tom130398/Temperature-Sensor-Arduino-/README.pdf

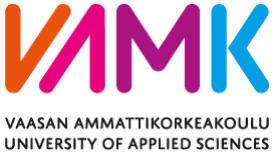
[picture p1: figure]

Luong Diem Quynh (e1601128)

Tuan Hoang Nguyen (e1601111)

Van Quy Thanh (e1601139)

# ELECTRONIC THERMOSTAT

Digital System Design

School of Technology

### CONTENTS

According to our research, the cheapest solution to transfer can be

found are RS232VSCurrent loop and RS232, with the price is

8.2 You need to make your PCB (embedded system) compliant with EMC.

8.4 What is the inductance (nH/cm) for PCB-trace which w = 10 cm, wt =

8.5 In circuit theory capacitor is pure (ideal) capacitor. Which components

### 1 ABSTRACT

In this course, we learn about the mechanism of electronic components for both

analog and digital and how they can be connected and communicated to microcon-

trollers. We also have a chance to develop and build a small microcontroller-based

system, which is a electronic thermostat in this case.

### 2 INTRODUCTION

We perform this laboratory report in order to record our work process during the

whole course and to understand more about the concept of electronic components

and how to use them to build a system. This report also resumes our total 112h work

load during the course. The contents include our understanding of electronic design

and mechanism of electronics components. Digital systems simulation, operations

of electrical components embedded to a microcontroller, Printed Circuit Board de-

sign methods and manufacturing. EMC-interferences and testing, robust design.

### 3 PRE-DESIGN

### 3.1 Device description

As requirements, the product has to manage the property monitoring and control.

The product will be used in small summer cottage or middle size summer cottage.

The designed device is consumer product and it can be used for other small build-

ings monitoring as well. The marketing area for the product is world-wide. The

product contains a temperature measurement system which can be used to measure

temperature at distance of 100 meters (wireless communication cannot be used be-

cause of steel walls between measurement point and the main device).

### 3.2 Functional Requirements

### 3.2.1 Temperature Measurement

Several requirements have to be reached when implementing temperature measure-

ment part inside products

1. The ambient of temperature is by 0.5 ° C accuracy
2. Measurement range should be at least -30 + 30 ° C
3. Measured temperature is constantly informed in device screen.

### 3.2.2 Communication

When implementing the communication part of device, we should also consider

these conditions

1. The transmitter is capable of transferring temperature information at least

100 meters.

2. Environment contains sensors are equipped with transmitter.
3. Main unit contains intelligence and sensor inputs.
4. Transmitter does not use expensive components.
5. Communication can be used in environment which contains electromag-

netic interference (communication should not get interfered because of dy-

namic 10 V/m electric field).

### 3.2.3 Heat Control

Heat control is also a necessary part of system and should meet some requirements

1. System is capable to control up to five radiators and each radiator contains

three different size heat resistors.

2. Each resistor can be controlled separately and each radiator contains its own

control relays.

3. User can adjust desired temperature by using keyboard (0.5° C accuracy).
4. Temperature control must take place in one second response time.

### 3.2.4 Antitheft Alarm System

The system is capable to maximum eight events at the same time (doors, windows

or other hatches). In addition it is possible to connect five motion detectors and

five smoke alarms to the system. The motion detectors and the smoke detec-

tors will provide an alarm (binary information). The system should inform alarms

by siren and flashing lights. The basic system does not need to be a remote con-

trolled, but remote controller feature should be taken into account because of the

device future generations.

It is possible to turn off the alarm system from its own keyboard. The password

needed when user wants to turn off the alarm system. The alarm system should

contain a delay function which means that the alarm is given after 15/30 seconds

from sensor event. Delayed alarm should be informed with buzzer.

### 3.2.5 Temperature Registration

The functionality of temperature registration also needed to be ensured

1. Device is capable to collect measured data
2. Memory data should be big enough for one week data quantity
3. User can browse measured results in device screen or results can be sent via

serial communication to personal computer

4. Measured values should be kept in the memory during power failure at least

five hours

5. User can change the sampling rate of measurement values.

### 3.2.6 Interfaces requirements

1. Device should contain a keyboard which can be used to set value for tem-

perature control. The keyboard can be used to feed password. The device

should contain a display to show temperature values

2. The device can be controlled from personal computer which uses RS-232

communication between device and personal computer.

3. The device collects measured data and counts every single day minimum

temperature, maximum temperature and average temperature

4. The device can be programmed via serial communication and the data can

downloaded to personal computer via serial communication. Serial commu-

nication settings are fixed so settings not need to be changed

### 3.2.7 Other requirements

- Accuracy of measurement 0.5 °C
- Range of measurement. -30 °C ... +30 °C
- Response time for control 1 s
- Responding to the alarm 0.5 s
- Easy to use and no special skills needed from user.
- Must be protected against power failure. The device is able to be in idle state for at least five hours.
- Device parameters can be changed from device keyboard and from personal computer
- The device operating temperature range should be -40 °C ... 50 °C and environment relative humidity < 90%.

### 3.2.8 Design Restrictions

- The device should be small as possible
- Only GCC C-compiler allowed when developing the software.
- The power consumption should be as small as possible.

### 3.3 Block diagram of the device

Base on requirement description, we came up with the system component structure

under block diagram. The block diagram can be seen under figure 1 below.

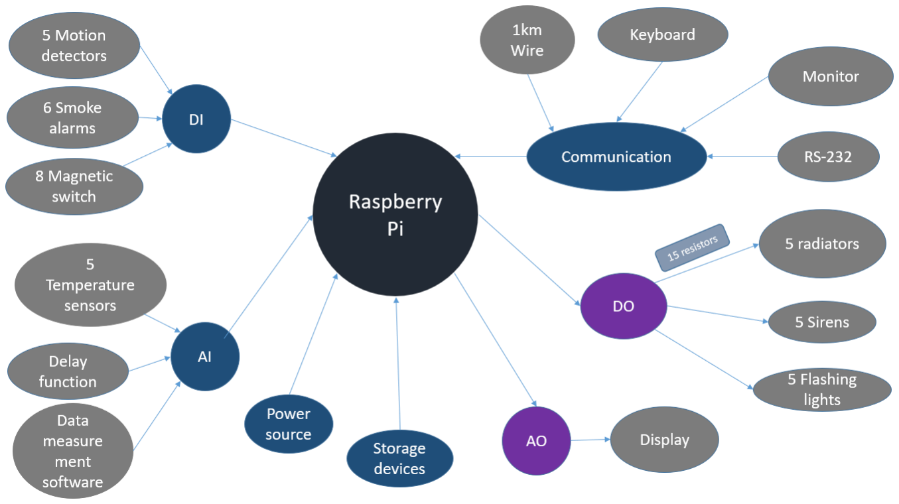
[picture p2: figure]

Figure 1. Block diagram that describe structure of device

Inside this block diagram, we use Raspberry Pi as a middle device that receives

every input and sends out data as an output in the system. Any devices or compo-

nents which is connected to Raspberry Pi as an input will have blue color, outputs

are purple and outer devices will have gray color. As we defined color of different

components in this way, it is easier for us to look at and build system later on.

For example, Digital Input (DI) is connected as an input device to Raspberry Pi

(because it has blue color) and there are three other components also connected as

inputs of DI which are: 5 motion detectors, 6 smoke alarms and 8 magnetic

switches. For another example, Analog Output (AO) is connected as an output to

Raspberry Pi (because it is purple) and it has other devices to connected to as its

output which is Display (Display analog statistics on user device). Or simply, we

just need to take a look on the arrow direction.

### 3.4 Device features

### 3.4.1 Manufacturing price

Base on the block diagram that has been defined on previous part, we will consider

about device features and price for a completed device.

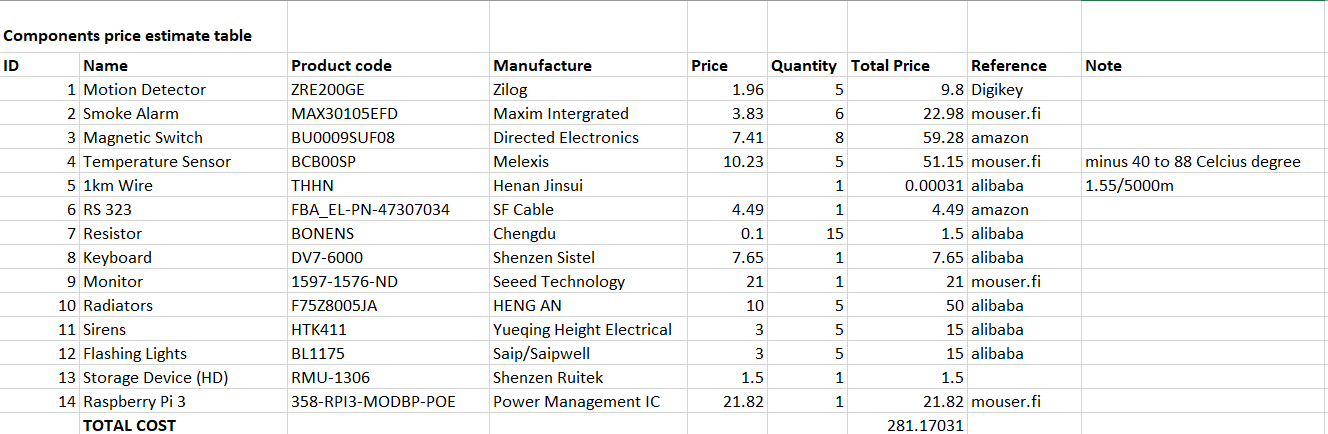
[picture p3: figure]

Figure 2. Component Price Estimated Table.

We have made several researches on some popular websites which sells electronic

components and picked up the most suitable price and components for our digital

system. The component features, quantities and prices after being filtered can be

displayed on figure 2 above.

According to our research, the whole system cost will be approximately in 281 Dol-

lar (which is around 240 Euro). The estimated duration to manufacture and finish

this system will range from 50 to 100 hours with 2-3 people work together. Base on

Finnish work labor statistics, it costs around 10-15 Euro to hire a person to work in

1 hour. To sum up, base on our research about devices features and prices as well

as work labor statistics, we come up with the total price below

Maximum Manufacturing Cost = Components + Manufacturing Costs

Maximum Manufacturing Cost = 281 + 100 × 3 = 581 Euro

So, the maximum manufacturing cost for this digital system can be reach to 581

Euro as the highest peak.

With each system, we estimated profit for company is about 100-150 Euro. So, the

total cost that customer may have pay for this can be calculated as

Total Cost = Maximum Manufacturing Cost + Company Profit

Total Cost = 581 + 150 = 731 Euro

Base on the result, the total amount that customers need to pay for the whole system

is estimated as 731 Euro for each.

### 3.4.2 Accuracy of measurement

The temperature sensor which was chosen on previous part ranges from -40 to 80

degree of Celsius with accuracy value is 0.5 °C. It has a larger range than require-

ments (which ranges from -30 °C to 30 °C)

So, with this temperature sensor, the smallest measurable change in temperature

with this temperature sensor is 0.5 °C. And the minimum operating temperature is

-40 °C and the highest one is 80 °C.

### 3.5 Different communication methods

The comparison between different communication methods can be seen under the

table below, based on several factors : Distance between transmitter and receiver,

external factor communication, price, advantages and disadvantages.

Almost price statistics were taken from amazon so that we can have a fair compar-

ison when comparing the price among devices.

| Dis-tance | External factor communi-cation | Price | Advantages | Disadvantages
Current loop | 600m | For serial communication, a current interface that uses current instead of voltage for signaling. Current loops | 100-150 USD | Long distance and noise immune trans-mission of data | No mechanical or electri-cal standard

can be used over moder-

ately long distances

RS232 | 50ft | Serial | communication,

used to connecting com-

puter and its peripheral de-

vices to allow serial data

exchange between them.

14.95

USD

RS232 | interface | is
supported | in many

compatible legacy de-

vices due to its sim-

plicity

It supports long dis-

tances and with error

correction capabilities.

Low cost and immune

to noise

It is not suitable for chip

to chip or chip to sensor

device communications.

Supports lower speed for

long distances.

RS232 interface requires

separate transceiver chips

which will add cost to the

system.

It is unbalanced transmis-

sion.

RS485 | 4000ft | Star and ring topologies are not recommended because of signal reflections or ex-cessively low or high ter-mination impedance. If a star configuration is una-voidable, special RS-485 repeaters are available which bidirectionally listen for data on each span and then retransmit the data onto all other spans. | 15.95 USD | Immune to noise. | It supports single master and multiple slaves.
RS232V SCur-rent loop | 500ft | can accept loop currents of either 20mA or 60mA and convert them to RS-232 data. | 82 EUR | Provide better protec-tion against the electri-cal interference gener-ated by the air

| suited to protecting data communication being car-ried out in environments where the terminating equipment has high voltage sources. | | conditioning unit, it can accept loop cur-rents of either 20mA or 60mA and convert them to RS-232 data.
CAN BUS | communicate with each other in applications with-out a host computer (https://en.wikipedia.org/wiki/Host_computer) | 14.55 USD | Supports distributed real-time control with a very high level of se-curity. Provide feature im-proves the network re-liability and transmis-sion efficiency | It is likely to have unde-sirable interactions be-tween nodes. CAN driver must produce at least 1.5V across typi-cal 60 Ohm. Network should be wired in topology which limits stubs as much as possible.

MOD

BUS

communication among

many devices connected to

the same network, for ex-

ample, | a | system | that

measures temperature and

humidity and communi-

cates the results to a com-

puter.

49.99

USD

offers flexibility of

type of data that can be

communicated to other

devices.

Data transfer designed

for industrial applica-

tions

Moves raw bits or

words without placing

restrictions on vendors

No standard method for a

node to find the descrip-

tion of a data object, i.e.

finding a register value

represents a temperature
between 30◦

and 175◦

No security against unau-

thorized commands or in-

terception of data

Transmissions must be

contiguous which limits

the types of remote com-

munications devices to

those that can buffer data to avoid gaps in the trans-

mission.

Table 1. Comparison between different communication method

According to our research, the cheapest solution to transfer can be found are

RS232VSCurrent loop and RS232, with the price is approximately 15 Euro.

### 4 ANALOG SIGNAL PROCESSING

### 4.1 Design

In this part, we will design temperature sensor circuit, buffer circuit and differential

amplifier circuit. Sensor LM35 output voltage will change -0.3V to +0.3V when

environment temperature changes -30 C to +30 C. The differential amplifier will be

used to gain input voltage (-0.3V to 0.3V) to wanted level (0V-3V) as we can see

under figure 3 below.

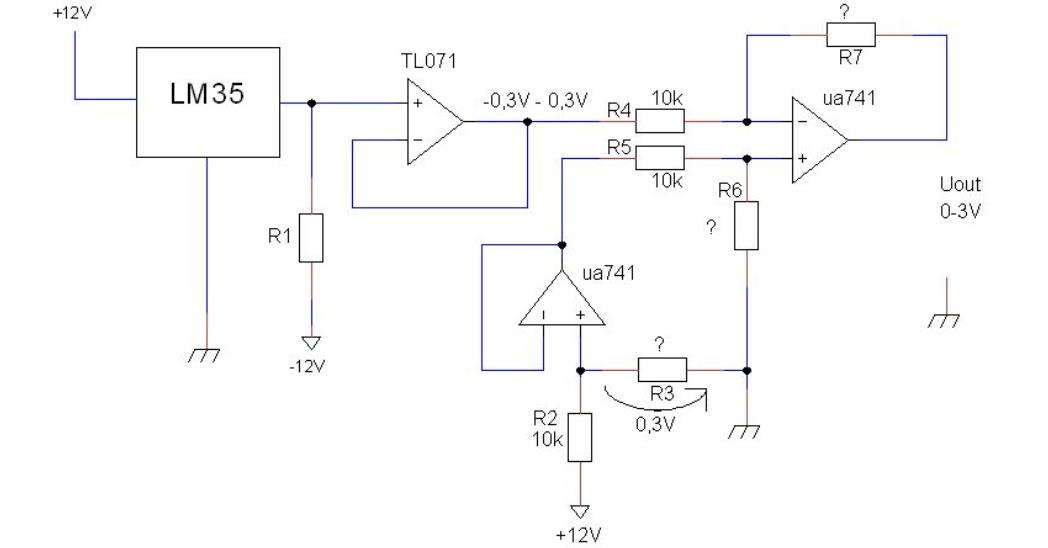
[picture p4: figure]

Figure 3. Differential amplifier circuit

The calculation process for two unknown components can be described below.

- R1

We will first start with R1

R1 = −

V2
50uA =

12
50uA = 240k
- R3

According to the voltage divider equation, we have U3
R3

=

U2
R2
We also have U3 = 0.3V,U2 = 12 − 0.3 = 11.7V U3
U2

=

R3
R2

=

1
39

R3 =

1
39 × R2 =

1
39 × 10000 = 256.41
- R6, R7

According to differential amplifier equation, we have : R6 = R7

Vout =

R7
R5

(Va − Vb)

We also have : Vout = 3V

R7 = −

Vout R5
Va − Vb = −

3 × 10k
(−0.3 − 0.3)

= 50k

So, in this case: R6 = R7 = 50k

### 4.2 Simulation

After calculating unknown component values, we have the LTSpice simulation as

can be seen under figure below. In this simulation, we measured and plotted the

diagram of I1 and V1

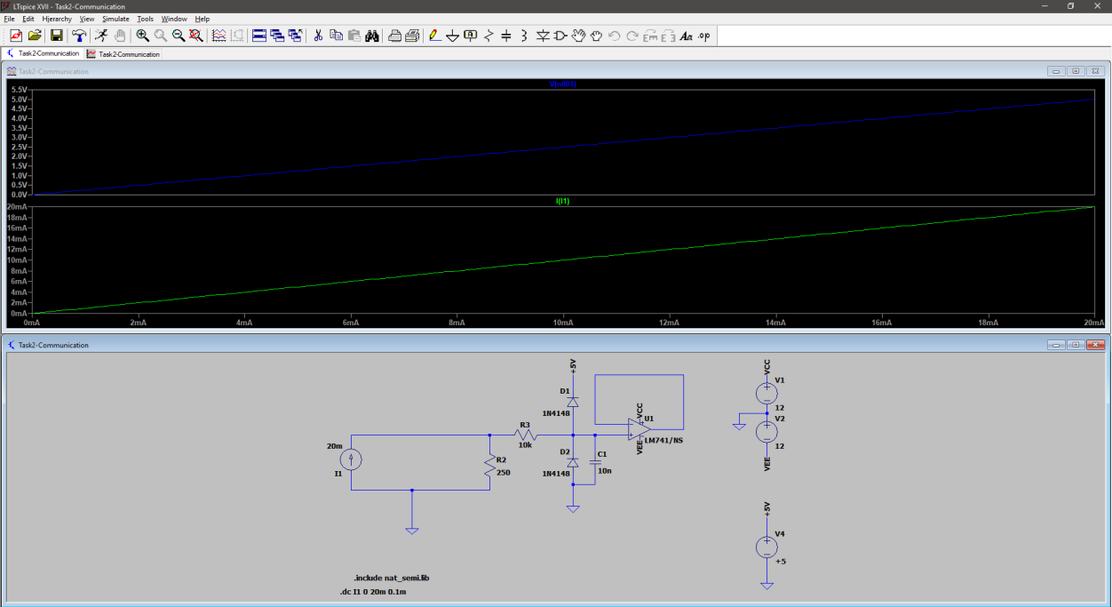
[picture p5: figure]

Figure 3. Simulation using LTSpice.

We can see that the two diagrams are corresponding to each other.

- V1 ranges from 0V to 5.5V
- I1 ranges from 0A to 20mA

With V1 = 0V, we have I1 = 0A as a corresponding value

With V1 = 5.5V, we have I1 = 20mA as a corresponding value.

### 4.3 Circuit testing and verification in breadboard

The breadboard general schematic can be found under figure 4 below.

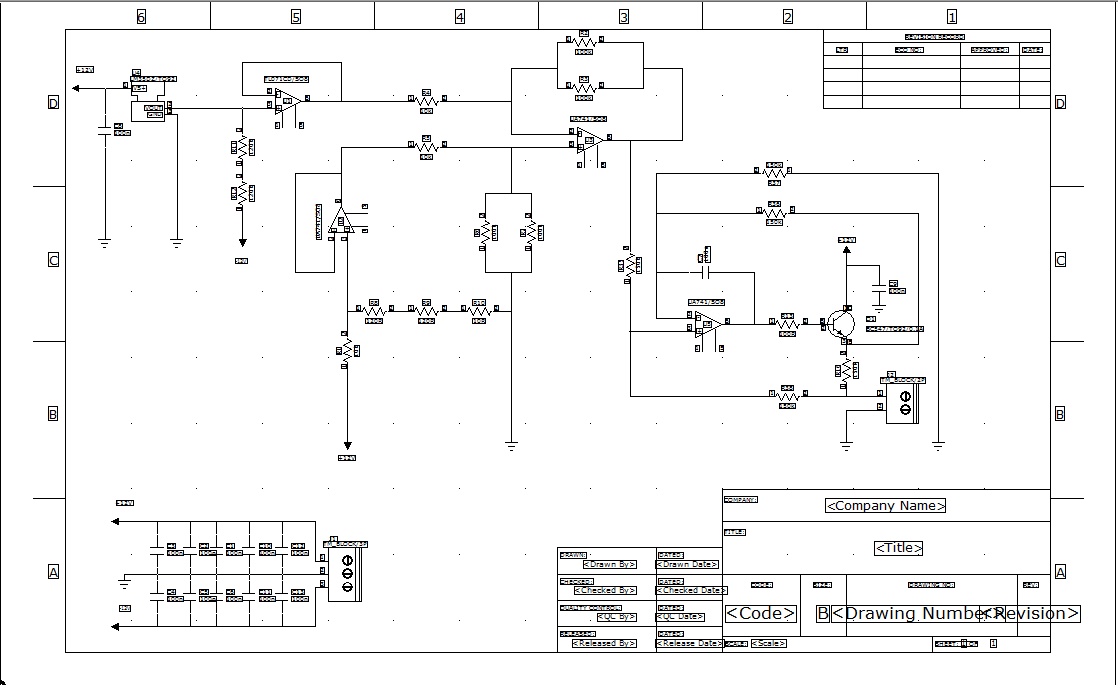
[picture p6: figure]

Figure 4. Bread board schematic

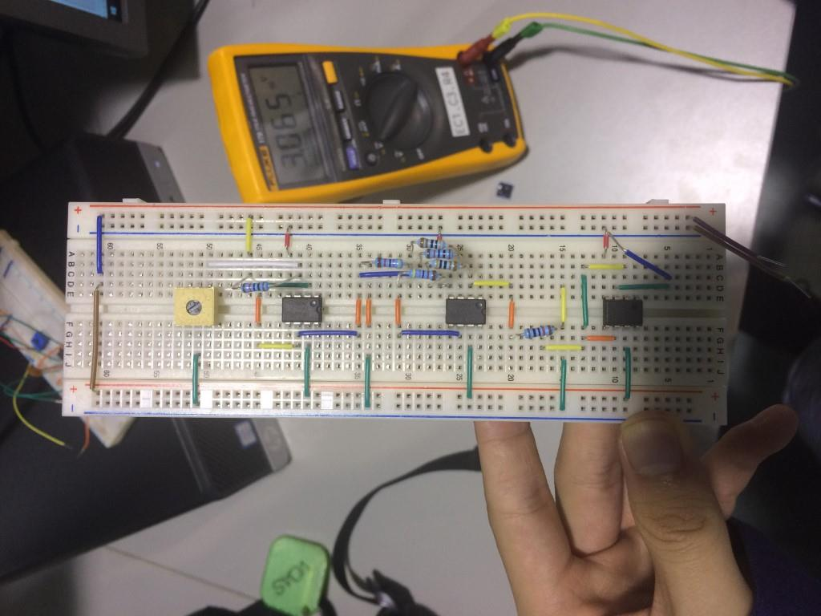
[picture p7: figure]

Figure 5. Bread board circuit

After finishing the circuit on breadboard, we did some measurement with input

voltage (Vin) and output voltage (Vout). Hence, we came up with the statistics can

be seen under figure 5 below.

From statistics gain from table, we can plot the diagram with two separated lines:

the blue line represents Vin while orange line represents Vout. The Vout line graph

increases while in the same time, Vin line graph is quiet decreasing by time.

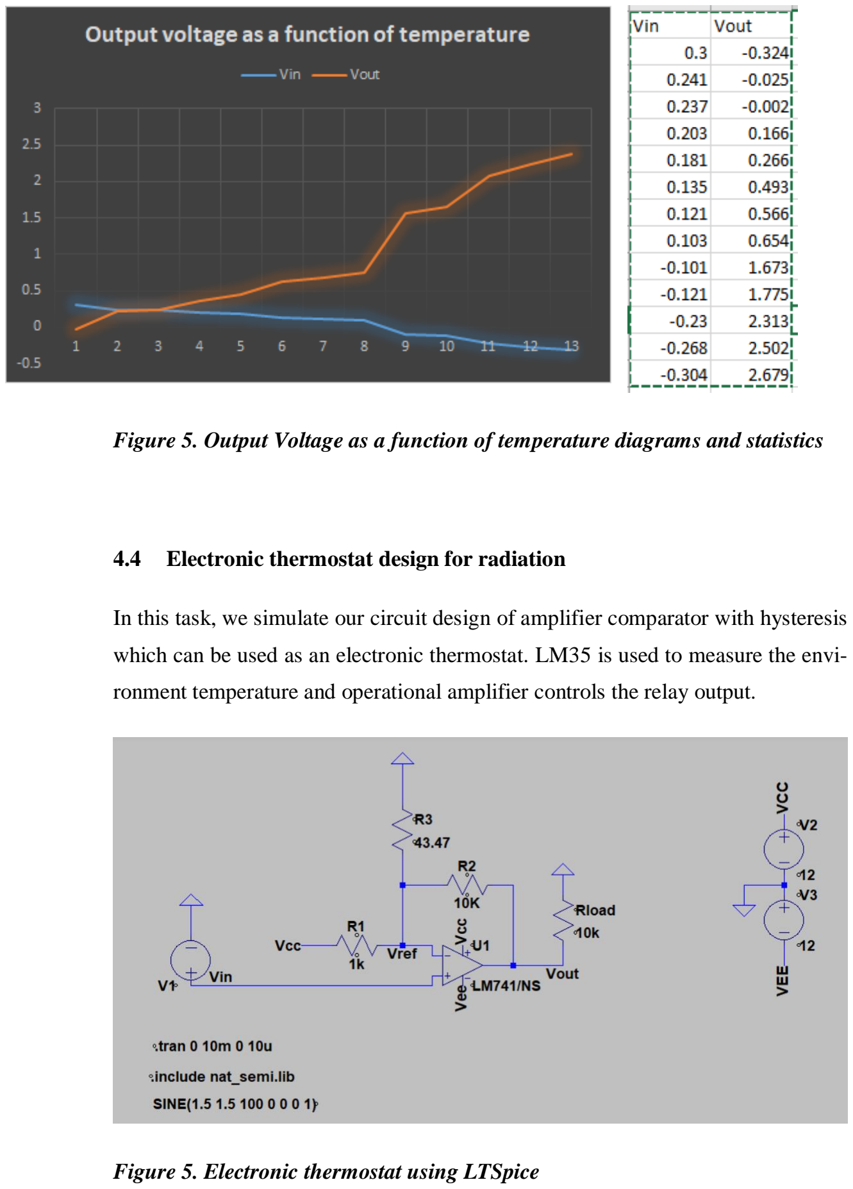
[picture p8: page 19]

Figure 5. Output Voltage as a function of temperature diagrams and statistics

### 4.4 Electronic thermostat design for radiation

In this task, we simulate our circuit design of amplifier comparator with hysteresis

which can be used as an electronic thermostat. LM35 is used to measure the envi-

ronment temperature and operational amplifier controls the relay output.

Figure 5. Electronic thermostat using LTSpice

The circuit plotting diagram can be seen under figure 6 below with three lines rep-

resent for three variables : V out, V in and V ref

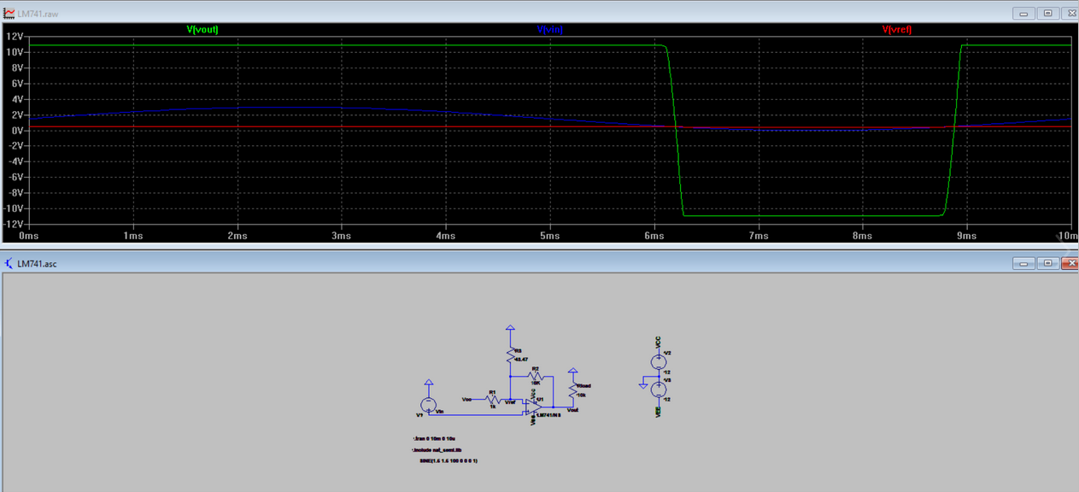
[picture p9: figure]

Figure 5. Electronic thermostat plotting diagram using LTSpice

### 5 COMMUNICATION

### 5.1 Transmitter

### 5.1.1 Design and calculation

In the previous part, we have designed and simulated temperature sensor circuit,

buffer circuit and a differential amplifier circuit. The solution is also tested and

verified in bread board.

In this part, we continue to build the remain part of system, transmitter. To simply

understand, the output of previous system is designed as an input for this system.

We have done the first part, now we continue moving on to next part. The circuit

can be seen under figure 7 below

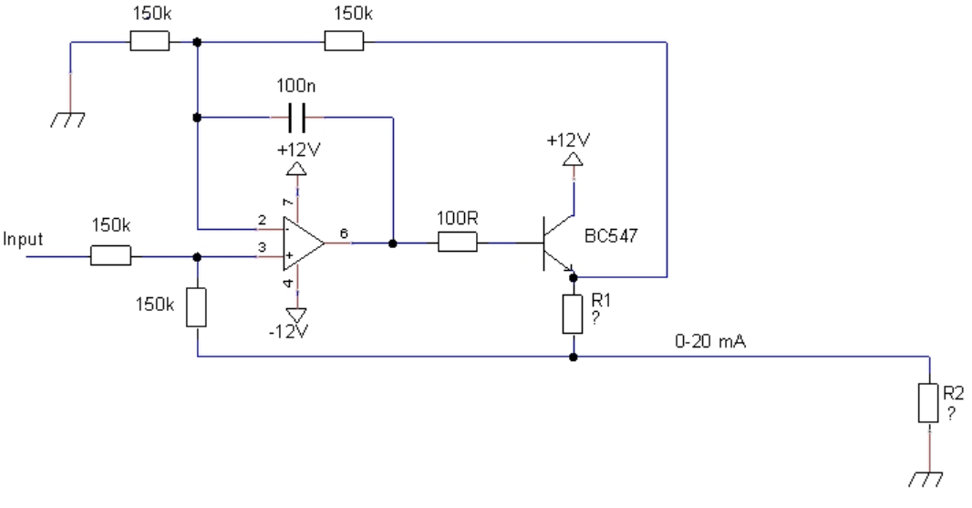
[picture p10: figure]

Figure 7. Communication Transmitter

- The BC548 is a general-purpose NPN bipolar junction transition com-

monly used in European and American electronic equipment. It is notably

often the first type of bipolar transistor hobbyists encounter and is often

featured in designs in hobby electronics magazines where a general-pur-

pose transistor is required. The BC548 is low in cost and widely available.

- An LM741 operational amplifier is a DC-coupled high gain electronic

voltage amplifier. It has only one op-amp inside. An operational amplifier

IC is used as a comparator which compares the two signal, the inverting

and non-inverting signal. The main function of this IC is to do mathemati-

cal operation in various circuits. Op-amps have large gain and usually used

as Voltage Amplifier. The LM741 can operate with a single or dual power

supply voltage.

- In order to have 0-20 mA current through R1 when input voltage varies 0-

3 V DC and current 20 mA flows in circuit the resistor R2 must have 5V

over it, the value of R1 and R2 should be

R1 =

Vin
I

=

3V
20mA = 150Ω

R2 =

V2
I

=

5V
20mA = 250 Ω

### 5.1.2 Simulation

Base on the obtained result on previous part, we come up with this circuit simulation

on LTSpice. As can be seen on plotting area under figure 8 below, two values have

been simulated. We can easily see that :

- With I = 0A, the corresponding value of V = 0V
- With I = 20mA, the corresponding value V = 5V

These simulation are exactly the same with requirements on design part.

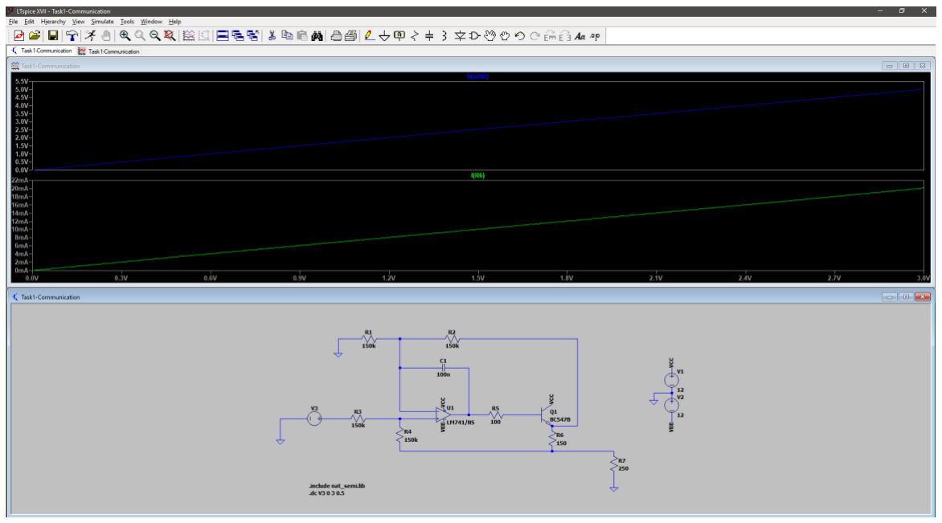
[picture p11: figure]

Figure 8. Communication Transmitter Simulation

### 5.1.3 Breadboard circuit testing and verification

The bread board implemented on circuit can be seen on figure 9 below. At this

point, we are testing and verifying this circuit using multimeters.

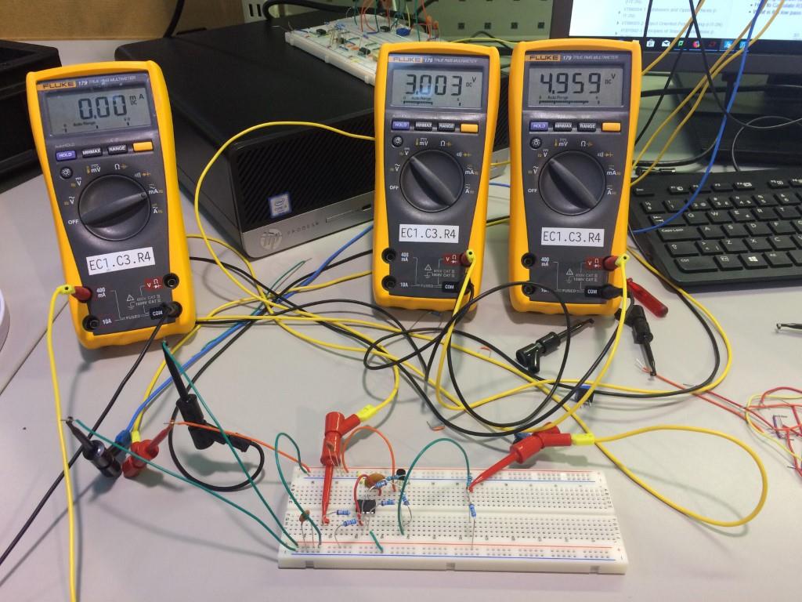
[picture p12: figure]

Figure 9. Communication Transmitter Circuit

After finishing the circuit on breadboard, we did some measurement with input

voltage (Vin) and output voltage (Vout). Hence, we came up with the statistics can

be seen under figure 10 below.

From statistics gain from table, we can plot the diagram with two separated lines:

the blue line represents Vin while orange line represents Vout. Both line graphs

have the same trend which are decreasing.

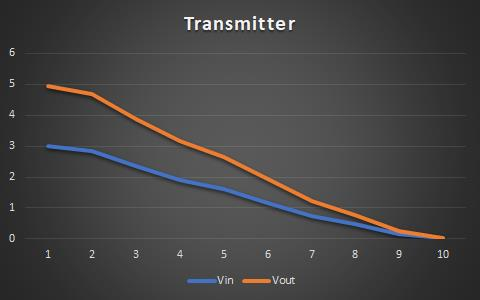
[picture p13: figure]
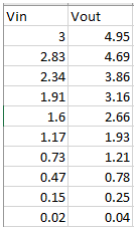
[picture p14: figure]

Figure 10. Communication Transmitter Diagram and Statistics

### 5.2 Receiver

### 5.2.1 Design and Calculation

The design of receiver can bee seen under figure 11 below.

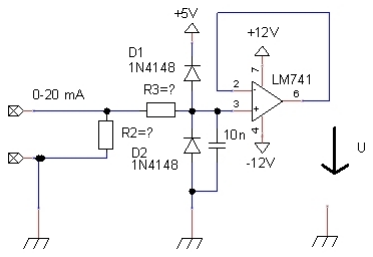
[picture p15: figure]

Figure 11. Communication Receiver Circuit

In order to have input signal contains 8 kV ESD discharge voltage and that current

during this ESD event through D1 or D2 is 0.8A, we should have value of R2 and

R3 as below

R2 =

Vin
I

=

5V
20mA = 250Ω

R3 =

V3
I3

=

8000V
0.8A

= 10000 Ω

The low pass filter cut-off frequency is

f =

1
2πRC =

1
2π × 10000 × 10 × 10⁻⁹

= 1600 Hz

### 5.2.2 Communication Receiver Simulation

Base on the obtained result on previous part, we come up with this circuit simulation

on LTSpice. As can be seen on plotting area under figure 8 below, two values have

been simulated. We can easily see that :

- With I = 0A, the corresponding value of V = 0V
- With I = 20mA, the corresponding value V = 5V

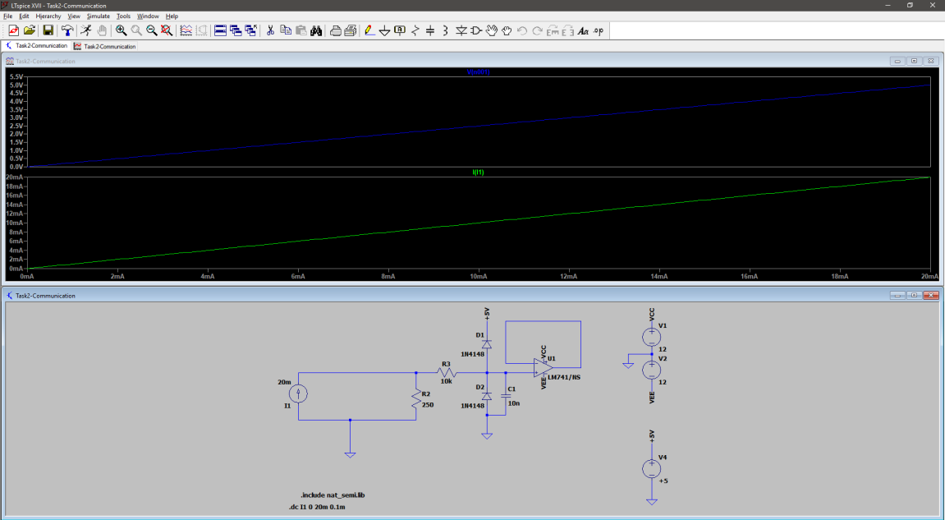
[picture p16: figure]

Figure 12. Communication Receiver Simulation

### 5.3 Test system in bread board

The receiver circuit bread board after being implemented can be seen as in the Fig-

ure 13 below. In this testing, we replace LM35 by DC-power supply and adjust -

0.3V to +0.3V using 0.1V steps. Measure current from current loop and measure

receiver output voltage.

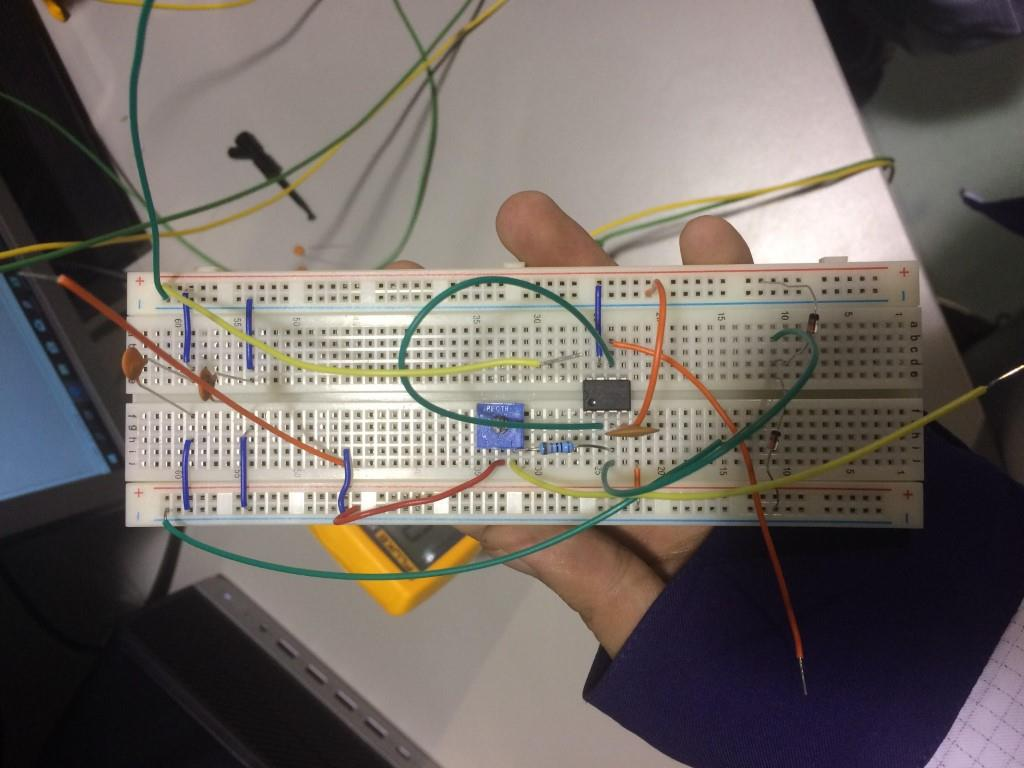
[picture p17: figure]

Figure 12. Communication Receiver Bread Board Circuit

After that, we did some measurement with input current (I in) and output voltage

(V out) of the receiver. Hence, we came up with the statistics can be seen under

figure 11 below. From statistics gain from table, we can plot the diagram with two

separated lines: the blue line represents Iin while orange line represents V out.

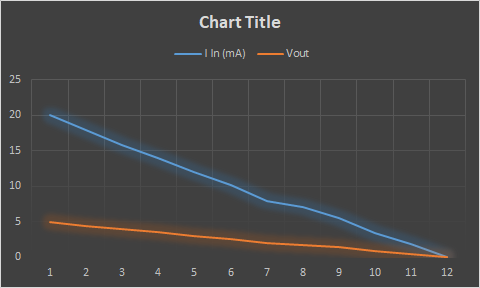
[picture p18: figure]

Figure 13. Communication Receiver Diagram and Statistics

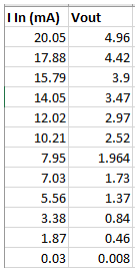
[picture p19: figure]

### 6 ANALOG TO DIGITAL CONVESION

### 6.1 Design

The different between MCP3002 and ADC0832 chips is described as

- MCP3002 is a 10-bit Analog-to-Digital Converter (ADC) combines high

performance and low power consumption in a small package, making it

ideal for embedded control applications. MCP3002 features 200k sam-

ples/second, 2 input channels, low power consumption (5nA typical

standby, 520µA typical active), and is available in 8-pin PDIP, SOIC and

TSSOP packages.

- ADC0832 is an 8-bit successive approximation A/D converter with a serial

I/O and configurable input multiplexers with up to 8 channels. The 2-, 4- or

8-channel multiplexers are software configured for single-ended or differ-

ential inputs as well as channel assignment.

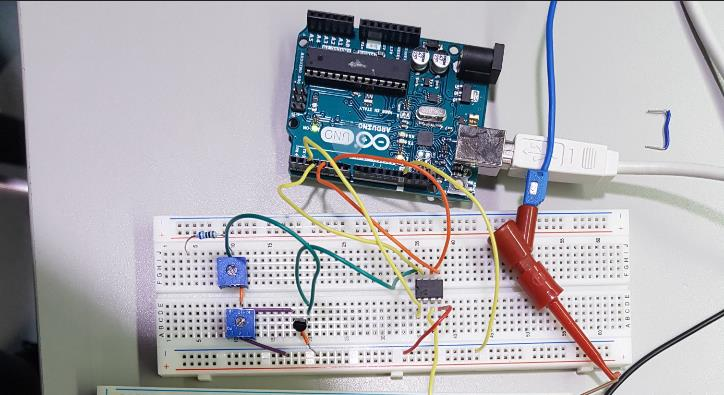
[picture p20: figure]

Figure 14. Circuit for the ADC use to measure temperature

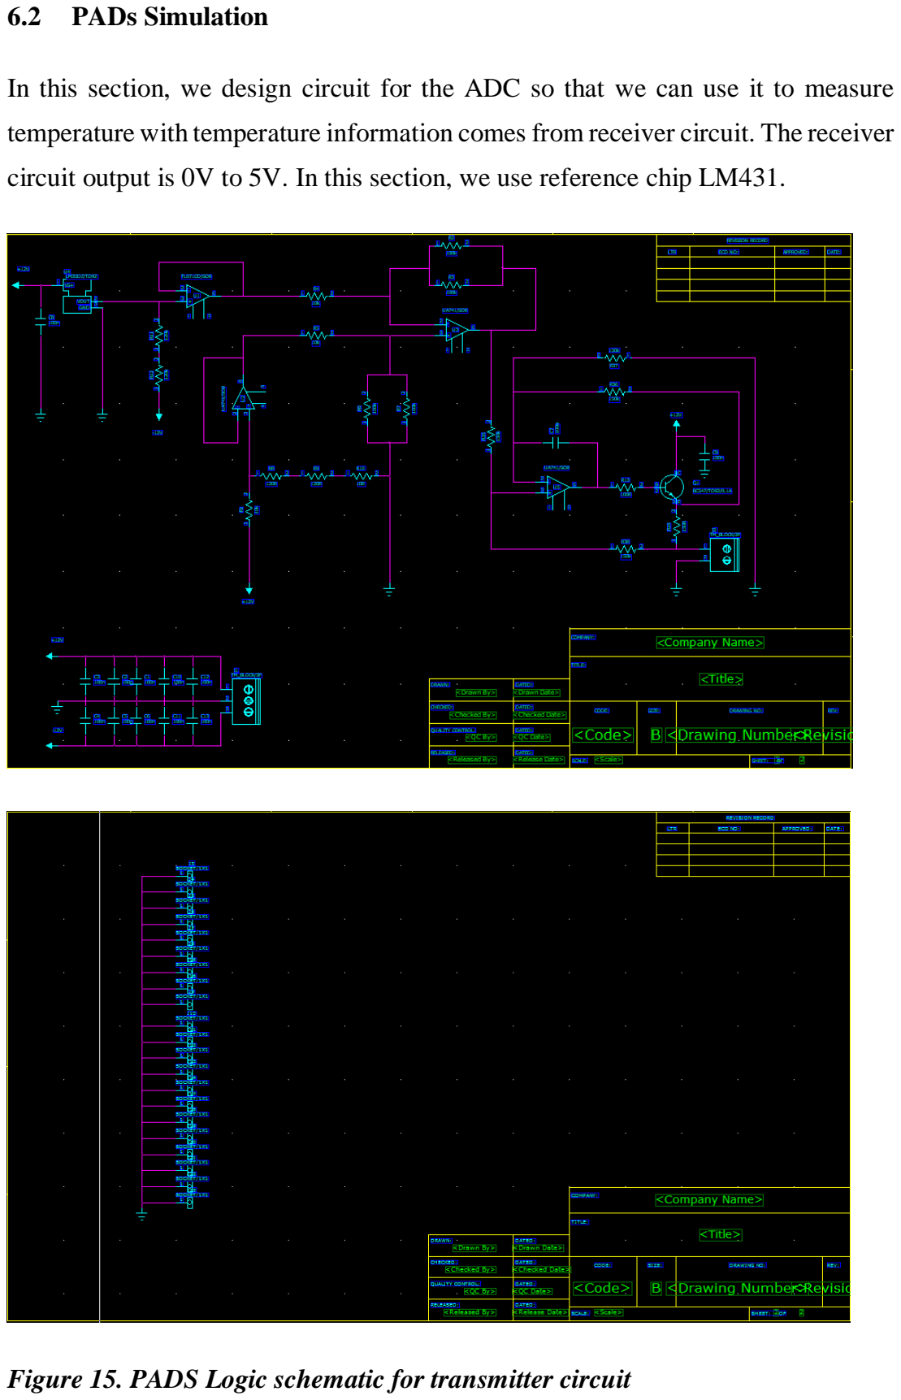
[picture p21: page 29]

### 6.2 PADs Simulation

In this section, we design circuit for the ADC so that we can use it to measure

temperature with temperature information comes from receiver circuit. The receiver

circuit output is 0V to 5V. In this section, we use reference chip LM431.

Figure 15. PADS Logic schematic for transmitter circuit

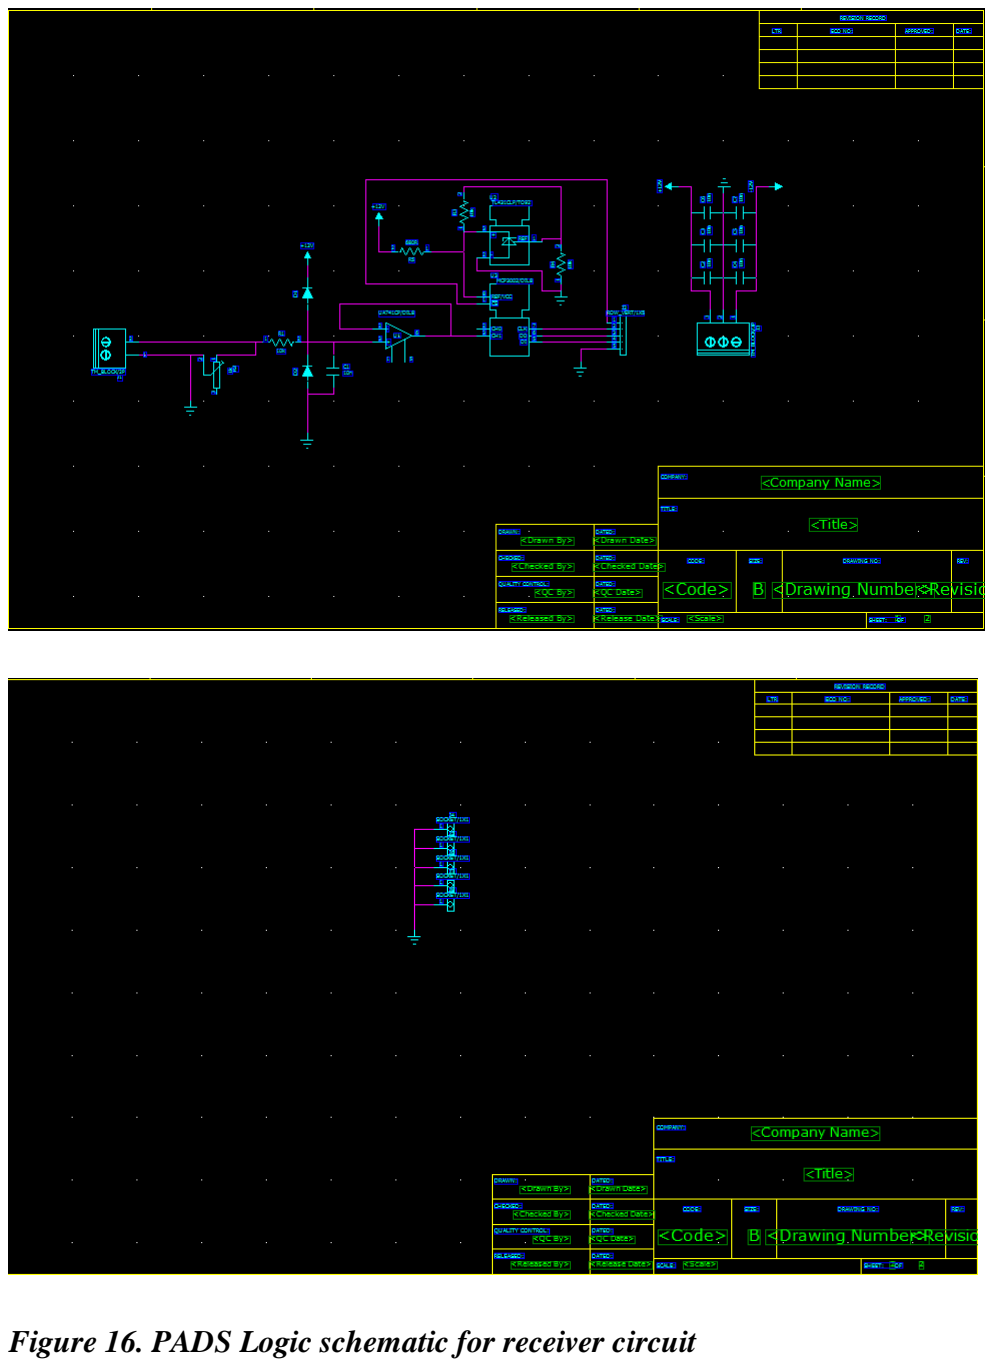
[picture p22: page 30]

Figure 16. PADS Logic schematic for receiver circuit

### 7 SCHEMATIC

### 7.1 Design transmitter and receiver using PADs

Our PADs design for transmitter and for receiver can be seen in figure 17.

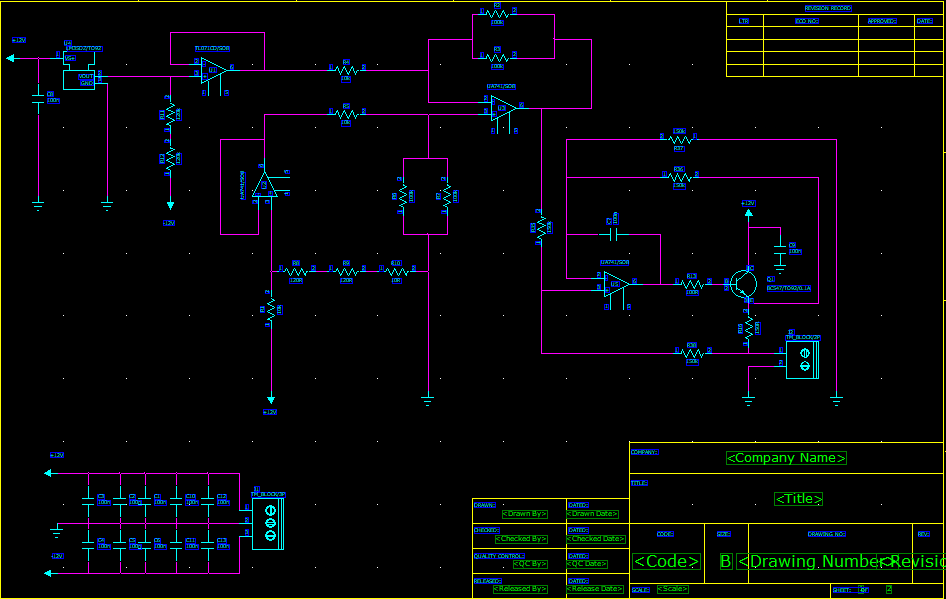
[picture p23: figure]

Figure 17. PADS Logic schematic for receiver circuit

### 7.2 Design printed circuit board (PCB)

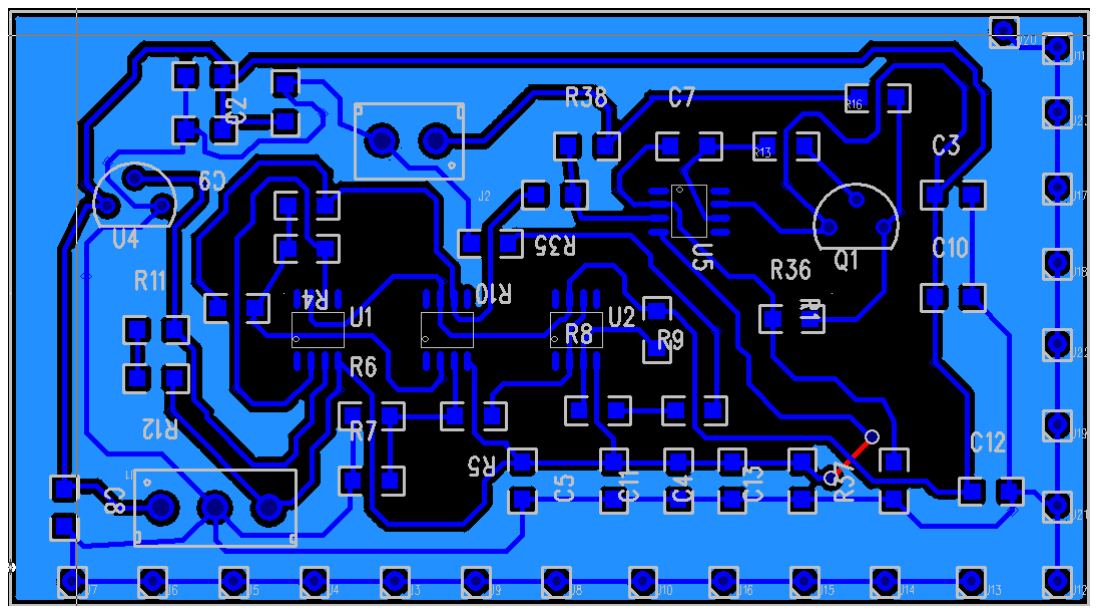
[picture p24: figure]

Figure 18. PCB board for the transmitter

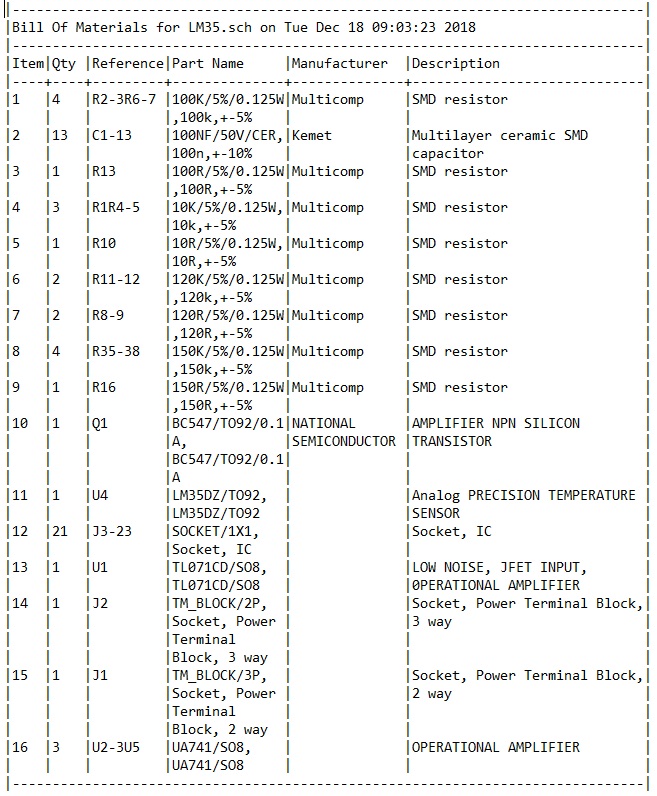
[picture p25: figure]

Figure 19. Bill of Material for Transmitter circuit

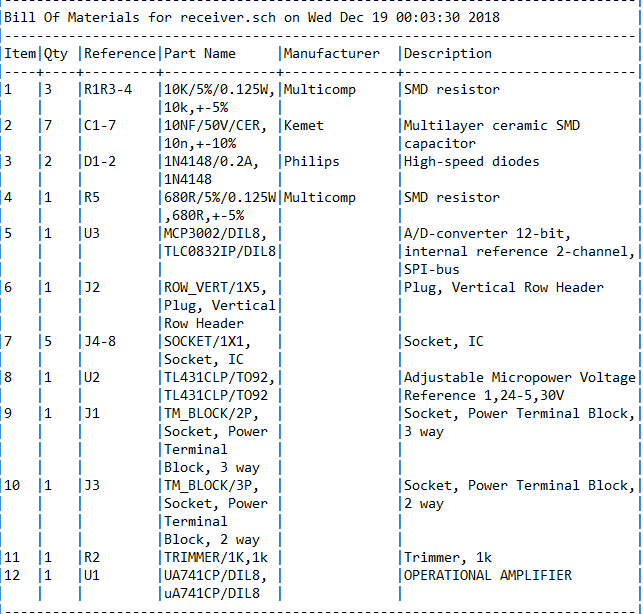
[picture p26: figure]

Figure 20. PCB board for the transmitter.

### 8 PRINTED CIRCUIT BOARD DESIGN

### 8.1 Explain following terms: EMC and EMI?

EMI: can be defined as electromagnetic energy which affects the functioning of an

electronic device. EMI source is another electronic device or electrical system.

While EMI can be generated from any electronic device, certain equipment and

components are more likely to have disturbances than others.

EMC: is a measure of a device's ability to operate as intended in its shared operating

environment while, at the same time, not affecting the ability of other equipment

within the same environment to operate as intended. Evaluating how a device will

react when exposed to electromagnetic energy is one component of this, known as

immunity (or susceptibility) testing.

### 8.2 You need to make your PCB (embedded system) compliant with EMC. List

the basic rules which your PCB should fulfill?

- Ground planes, copper areas covering smaller or larger areas of the

board

- Connect the PCB copper plane to the signal ground and ground plane

to the ground net

- Use short cables and smaller package
- Distance from the ground plane to the edge of the board should be

at least 0.5 mm and solder pads and wires are 0.25 mm

- Current mode should be installed
- Electromagnetic loop loop should be as small as possible
- Use component in correct size.
- Having a proper distance between components.

### 8.3 Why we need decoupling capacitor for each chip

By decoupling capacitor,noise caused by other circuit elements is shunted through

the capacitor, reducing the effect it has on the rest of the circuit. It also prevents the

resistor absorbing a portion of the AC (https://en.wikipedia.org/wiki/Alternating_current) output power of the amplifier.

### 8.4 What is the inductance (nH/cm) for PCB-trace which w = 10 cm, wt = 1mm

and h = 0.9 mm (hint: check curve in page 9)?

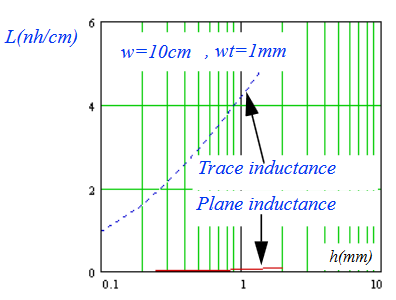
[picture p27: figure]

Figure 21. A VSS plane has a lower trace inductance and reduces the PCB track

inductance

According to the graph has been shown on figure 21, when comparing value of a

PCB-trace which has the specified value: w = 10cm, wt = 1mm and h = 0.9mm, we

got the result of the inductance is approximately 4nh/cm

### 8.5 In circuit theory capacitor is pure (ideal) capacitor. Which components you

need to model real world capacitor?

Component which is needed to model a real world can be listed below:

1. 2 metal plates
2. 1 dielectric.

The dielectric can be made out of all sorts of insulating materials: paper, glass, rub-

ber, ceramic, plastic, or anything that will impede the flow of current.

### 9 CONCLUSION

After this laboratory exercise, we understand more about the mechanism of elec-

tronics components (analog and digital) and know how they can be connected to a

microcontroller. We also learn about the design process of electronic systems. We

have chance to build a small microcontroller-based system.

### 10 REFERENCES

- Digital System Design Course (IIS2105-1)
- https://www.alibaba.com/
- https://www.mouser.fi/
- https://www.amazon.com/
- https://www.digikey.com/
- http://people.ece.cornell.edu/land/courses/ece4760/
- https://en.wikipedia.org/wiki/BC548
- https://www.com-power.com/emi-emc-differences.html
- https://en.wikipedia.org/wiki/Decoupling_capacitor
- https://en.wikipedia.org/wiki/Electromagnetic_interference
- https://en.wikipedia.org/wiki/Electromagnetic_compatibility
