tom130398/Temperature-Sensor-Arduino-/(list of files, drawings)

Other design files:
PADS Layout/circuit.pcb
PADS Layout/transmitter_2.pcb
